Nemonic-hub/Trepan2p/README.md

# Trepan2p
Resources from the work that is described in Stirman et al. 2016 Nature Biotechnology
