Nemonic-hub/Trepan2p/TL - 60mm Cage Plate 2.stl

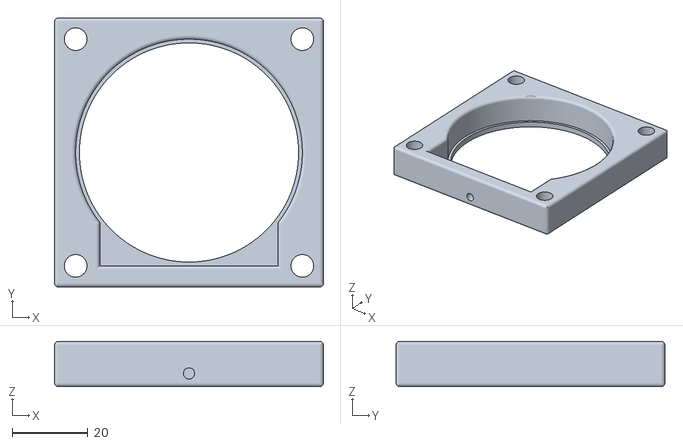
[picture p1: CAD file, 2016-08-23]
TL - 60mm Cage Plate 2.stl
71.2 x 71.2 x 12.0
