Nemonic-hub/Trepan2p/Obj - 30mm Lens Adapter.stl

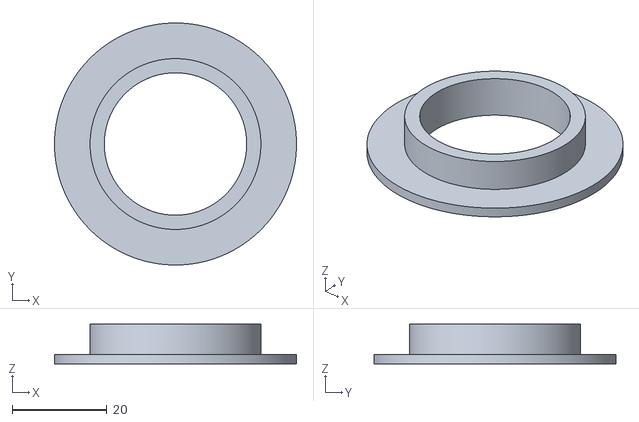
[picture p2: CAD file, 2016-08-23]
Obj - 30mm Lens Adapter.stl
51.0 x 51.0 x 8.40
