Nemonic-hub/Trepan2p/Relay Lens - 1in to 2in Adapter.stl

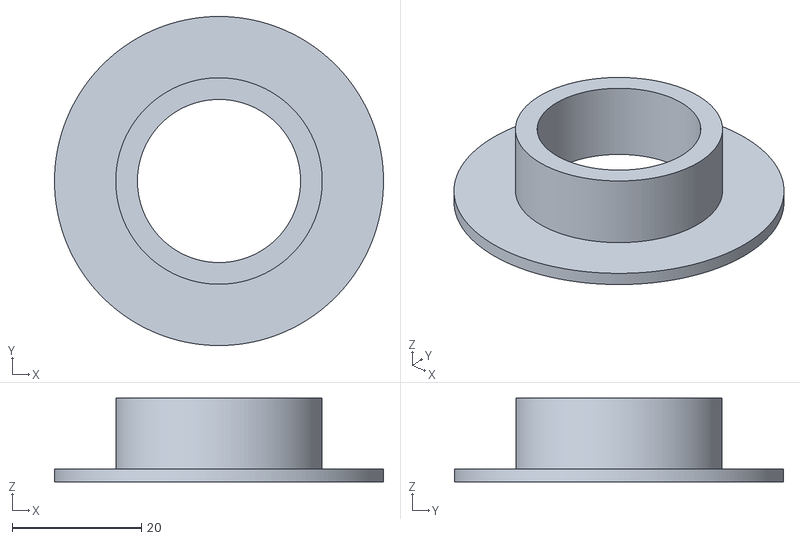
[picture p3: CAD file, 2016-08-23]
Relay Lens - 1in to 2in Adapter.stl
51.0 x 51.0 x 13.0
