Nemonic-hub/Trepan2p/(list of files, cad)

Other CAD files:
Relay Lens Adapter.dwg
60mm Cage Plate.dwg
30mm Lens Adapter.dwg
