Nemonic-hub/Trepan2p/(commit log)

2016-07-23 Added prescription data for the optical subassemblies
    Full descriptions of the optical subassemblies (beam recombination
    relay, XY scanner relay, scan lens, tube lens, and objective): radius,
    thickness, material, and semi-diameter. Part numbers and vendors are
    included for COTS (commercial, off-the-shelf) components.
2016-08-23 3D printed parts
    These parts were 3D printed and used to position lenses inside the lens tubes.
    [30mm Lens Adapter.dwg, 60mm Cage Plate.dwg, Obj - 30mm Lens Adapter.stl, Relay Lens - 1in to 2in Adapter.stl, Relay Lens Adapter.dwg, TL - 60mm Cage Plate 2.stl]
